OzcanBYK/OdaLambasi/Oda Lambası Mekanik Tasarım/3D Baskı/Oda Lambası - Plastik Kapak w DC Barrel.step

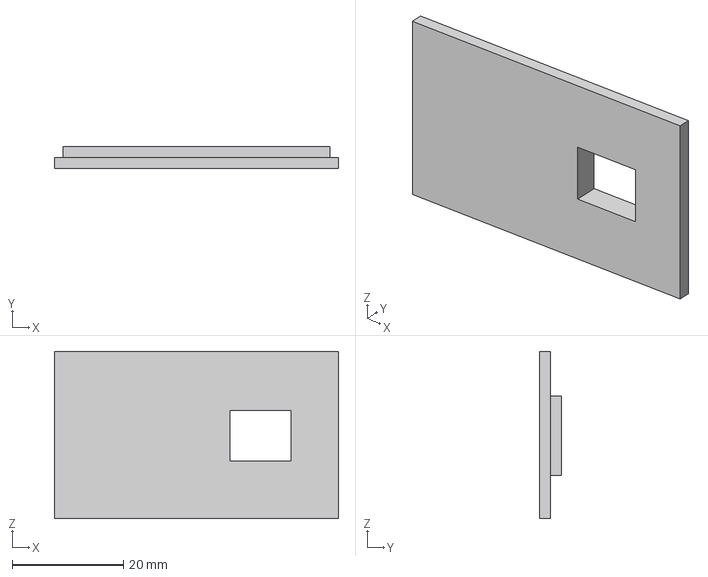
[picture p1: CAD file, 2023-02-04]
Oda Lambası Mekanik Tasarım/3D Baskı/Oda Lambası - Plastik Kapak w DC Barrel.step
51.0 x 4.00 x 30.0 mm
