OzcanBYK/OdaLambasi/Oda Lambası Mekanik Tasarım/Elektronik Parçalar/3.5 2'li Dişi Yatay Geçmeli Klemens.step

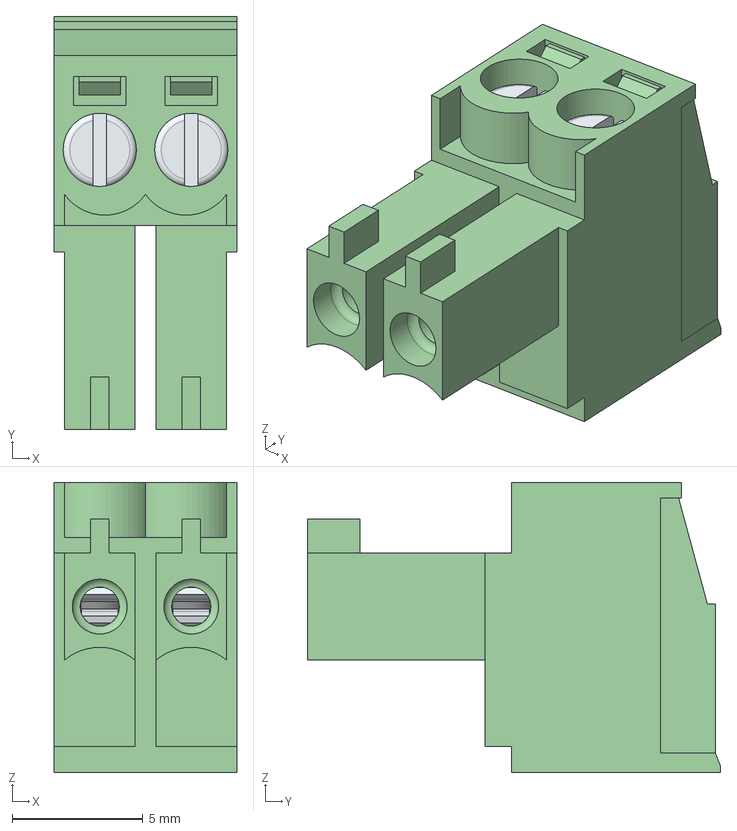
[picture p2: CAD file, 2023-02-04]
Oda Lambası Mekanik Tasarım/Elektronik Parçalar/3.5 2'li Dişi Yatay Geçmeli Klemens.step
7.00 x 15.8 x 11.1 mm
691364100002_M
6913611000xx_CAGE x 2
6913611000xx_VIS x 2
6913611000xx_PIN x 2
