OzcanBYK/OdaLambasi/Oda Lambası Mekanik Tasarım/Mekanik Parçalar/Oda Lambası - Pleksi.step

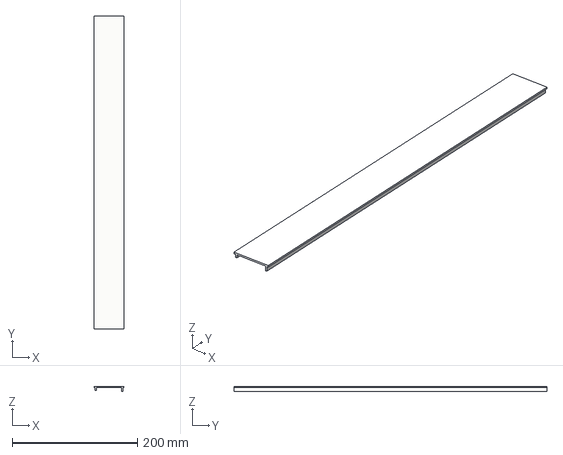
[picture p3: CAD file, 2023-02-04]
Oda Lambası Mekanik Tasarım/Mekanik Parçalar/Oda Lambası - Pleksi.step
48.0 x 500.0 x 8.00 mm
