OzcanBYK/OdaLambasi/Oda Lambası Mekanik Tasarım/3D Baskı/Oda Lambası - Kart Sabitleme Üst.step

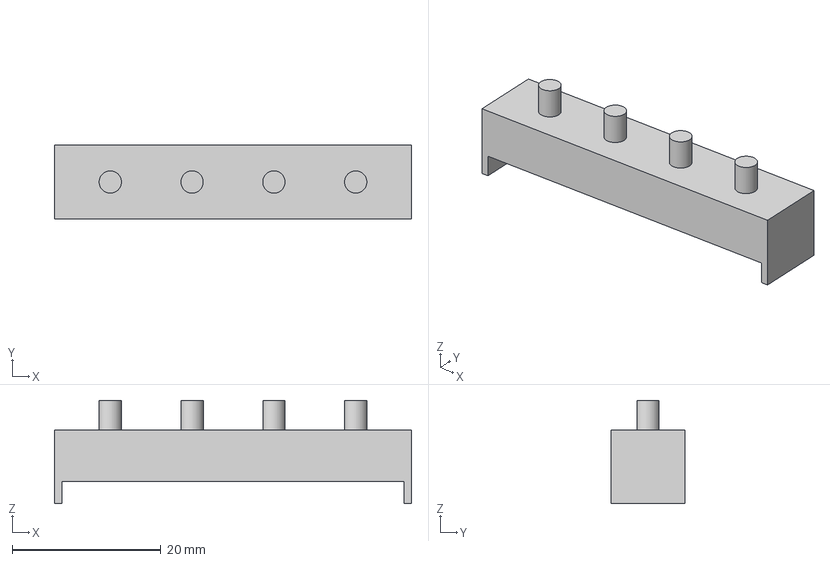
[picture p4: CAD file, 2023-02-04]
Oda Lambası Mekanik Tasarım/3D Baskı/Oda Lambası - Kart Sabitleme Üst.step
48.0 x 10.0 x 13.9 mm
