OzcanBYK/OdaLambasi/Oda Lambası Mekanik Tasarım/Elektronik Parçalar/DC Barrel Jack.step

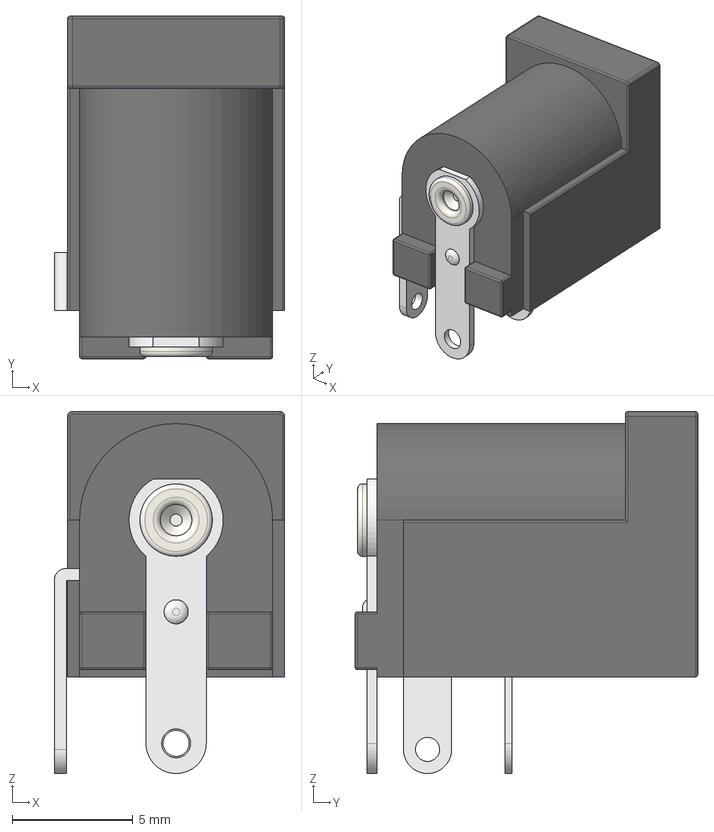
[picture p5: CAD file, 2023-02-04]
Oda Lambası Mekanik Tasarım/Elektronik Parçalar/DC Barrel Jack.step
9.55 x 14.2 x 15.0 mm
