OzcanBYK/OdaLambasi/Oda Lambası Mekanik Tasarım/Mekanik Parçalar/Oda Lambası - Aliminyum Gövde.step

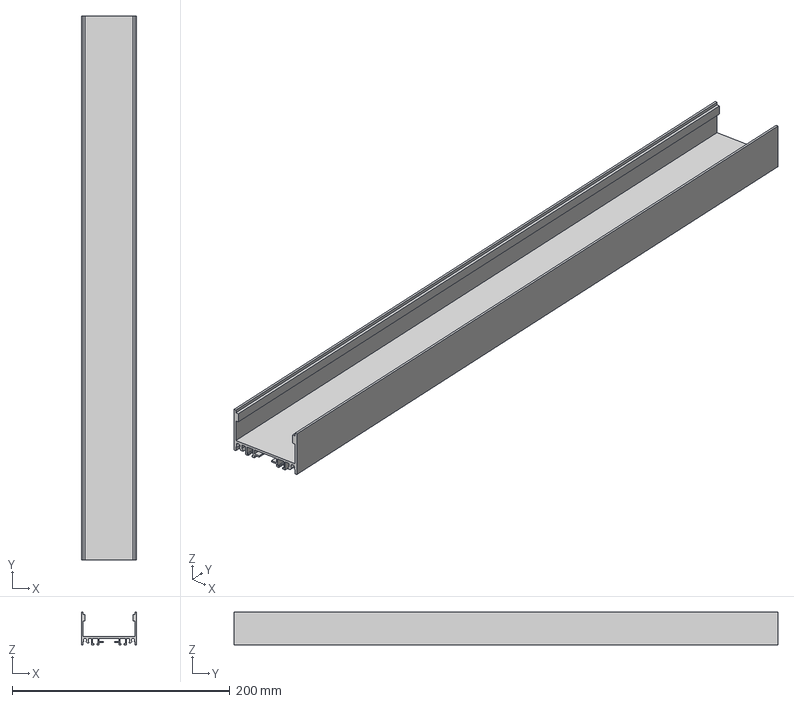
[picture p6: CAD file, 2023-02-04]
Oda Lambası Mekanik Tasarım/Mekanik Parçalar/Oda Lambası - Aliminyum Gövde.step
51.0 x 500.0 x 30.0 mm
