OzcanBYK/OdaLambasi/Oda Lambası Mekanik Tasarım/Elektronik Parçalar/3.5 4'lü Dişi Yatay Geçmeli Klemens.step

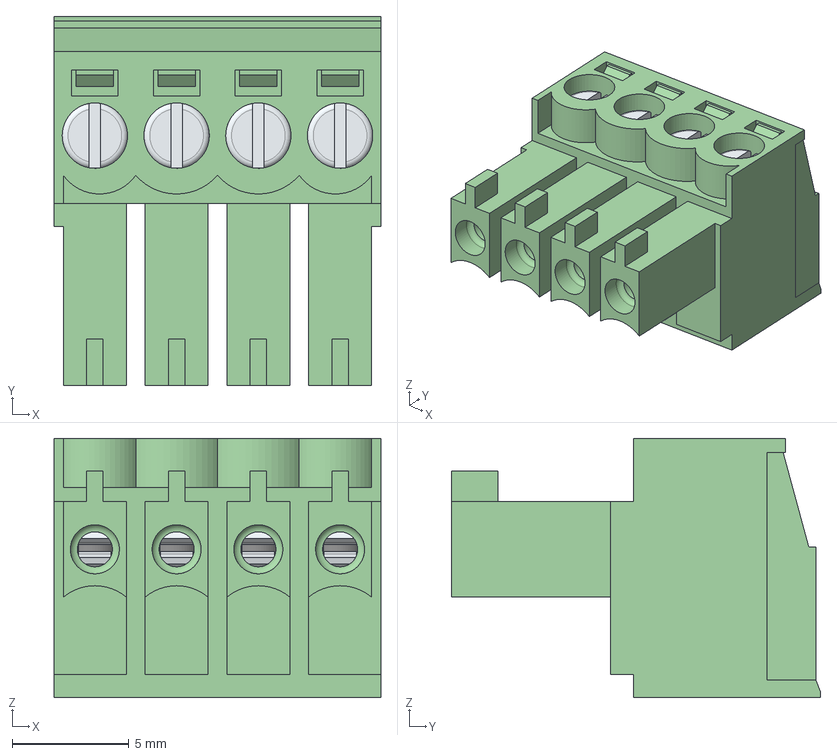
[picture p7: CAD file, 2023-02-04]
Oda Lambası Mekanik Tasarım/Elektronik Parçalar/3.5 4'lü Dişi Yatay Geçmeli Klemens.step
14.0 x 15.8 x 11.1 mm
6913611000xx_CAGE x 4
6913611000xx_VIS x 4
6913611000xx_PIN x 4
691364100004_M
