OzcanBYK/OdaLambasi/Oda Lambası Mekanik Tasarım/3D Baskı/Oda Lambası - Kart Sabitleme Alt.step

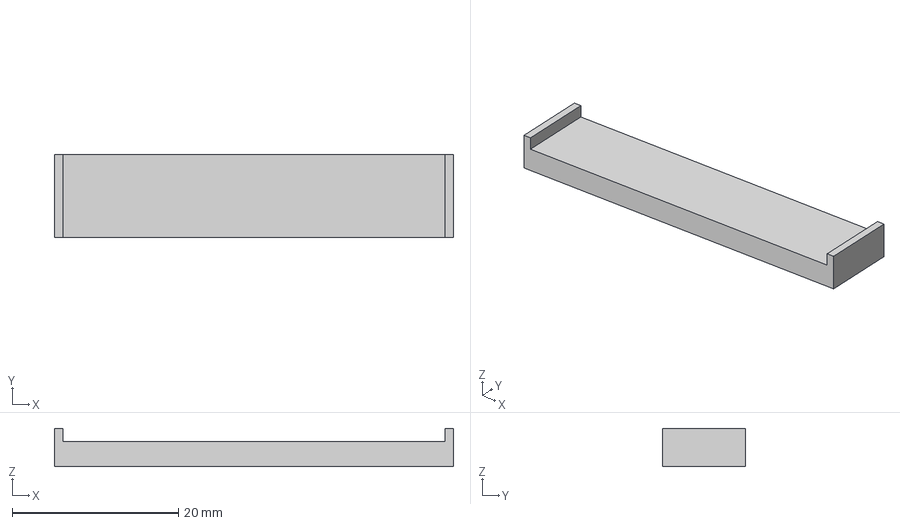
[picture p8: CAD file, 2023-02-04]
Oda Lambası Mekanik Tasarım/3D Baskı/Oda Lambası - Kart Sabitleme Alt.step
48.0 x 10.0 x 4.60 mm
