OzcanBYK/OdaLambasi/Oda Lambası Mekanik Tasarım/Elektronik Parçalar/Oda Lambası Led.step

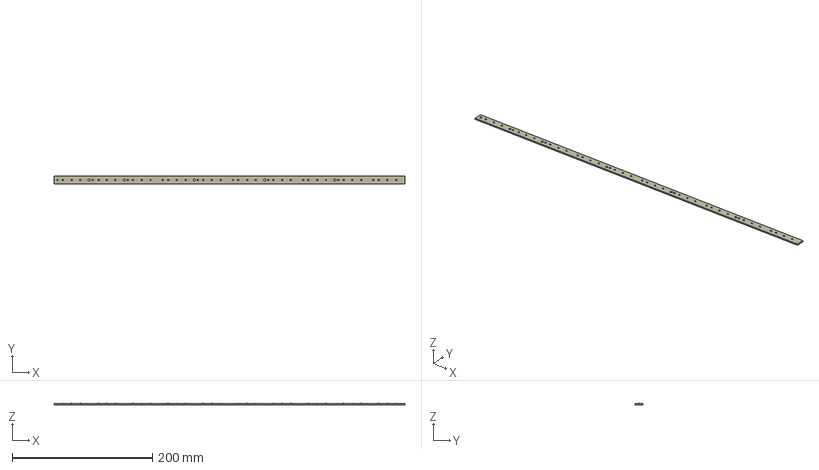
[picture p9: CAD file, 2023-02-04]
Oda Lambası Mekanik Tasarım/Elektronik Parçalar/Oda Lambası Led.step
500.0 x 11.0 x 2.42 mm
Board
R0805 x 10
