OzcanBYK/OdaLambasi/Oda Lambası Mekanik Tasarım/3D Baskı/Oda Lambası - Led Sabitleme.step

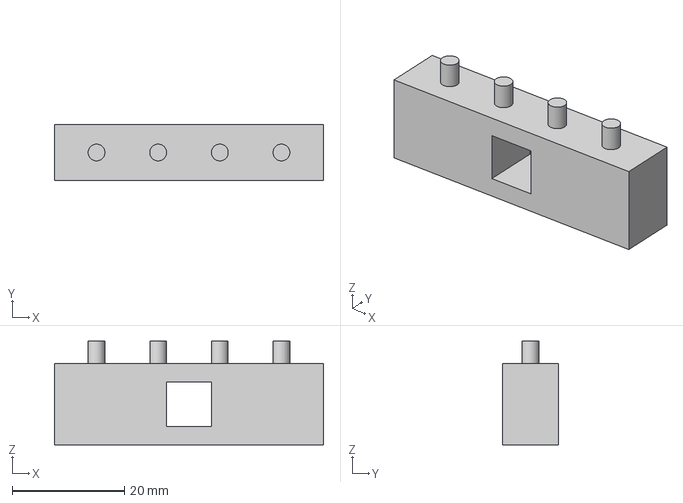
[picture p10: CAD file, 2023-02-04]
Oda Lambası Mekanik Tasarım/3D Baskı/Oda Lambası - Led Sabitleme.step
48.0 x 10.0 x 18.5 mm
