OzcanBYK/OdaLambasi/(list of files, cad)

Other CAD files:
Oda Lambası Mekanik Tasarım/3D Baskı/Oda Lambası - Plastik Kapak.step
