OzcanBYK/OdaLambasi/Kart Tasarımları/Oda Lambası V0.01.brd

## EAGLE design Kart Tasarımları/Oda Lambası V0.01.brd (2023-01-30)

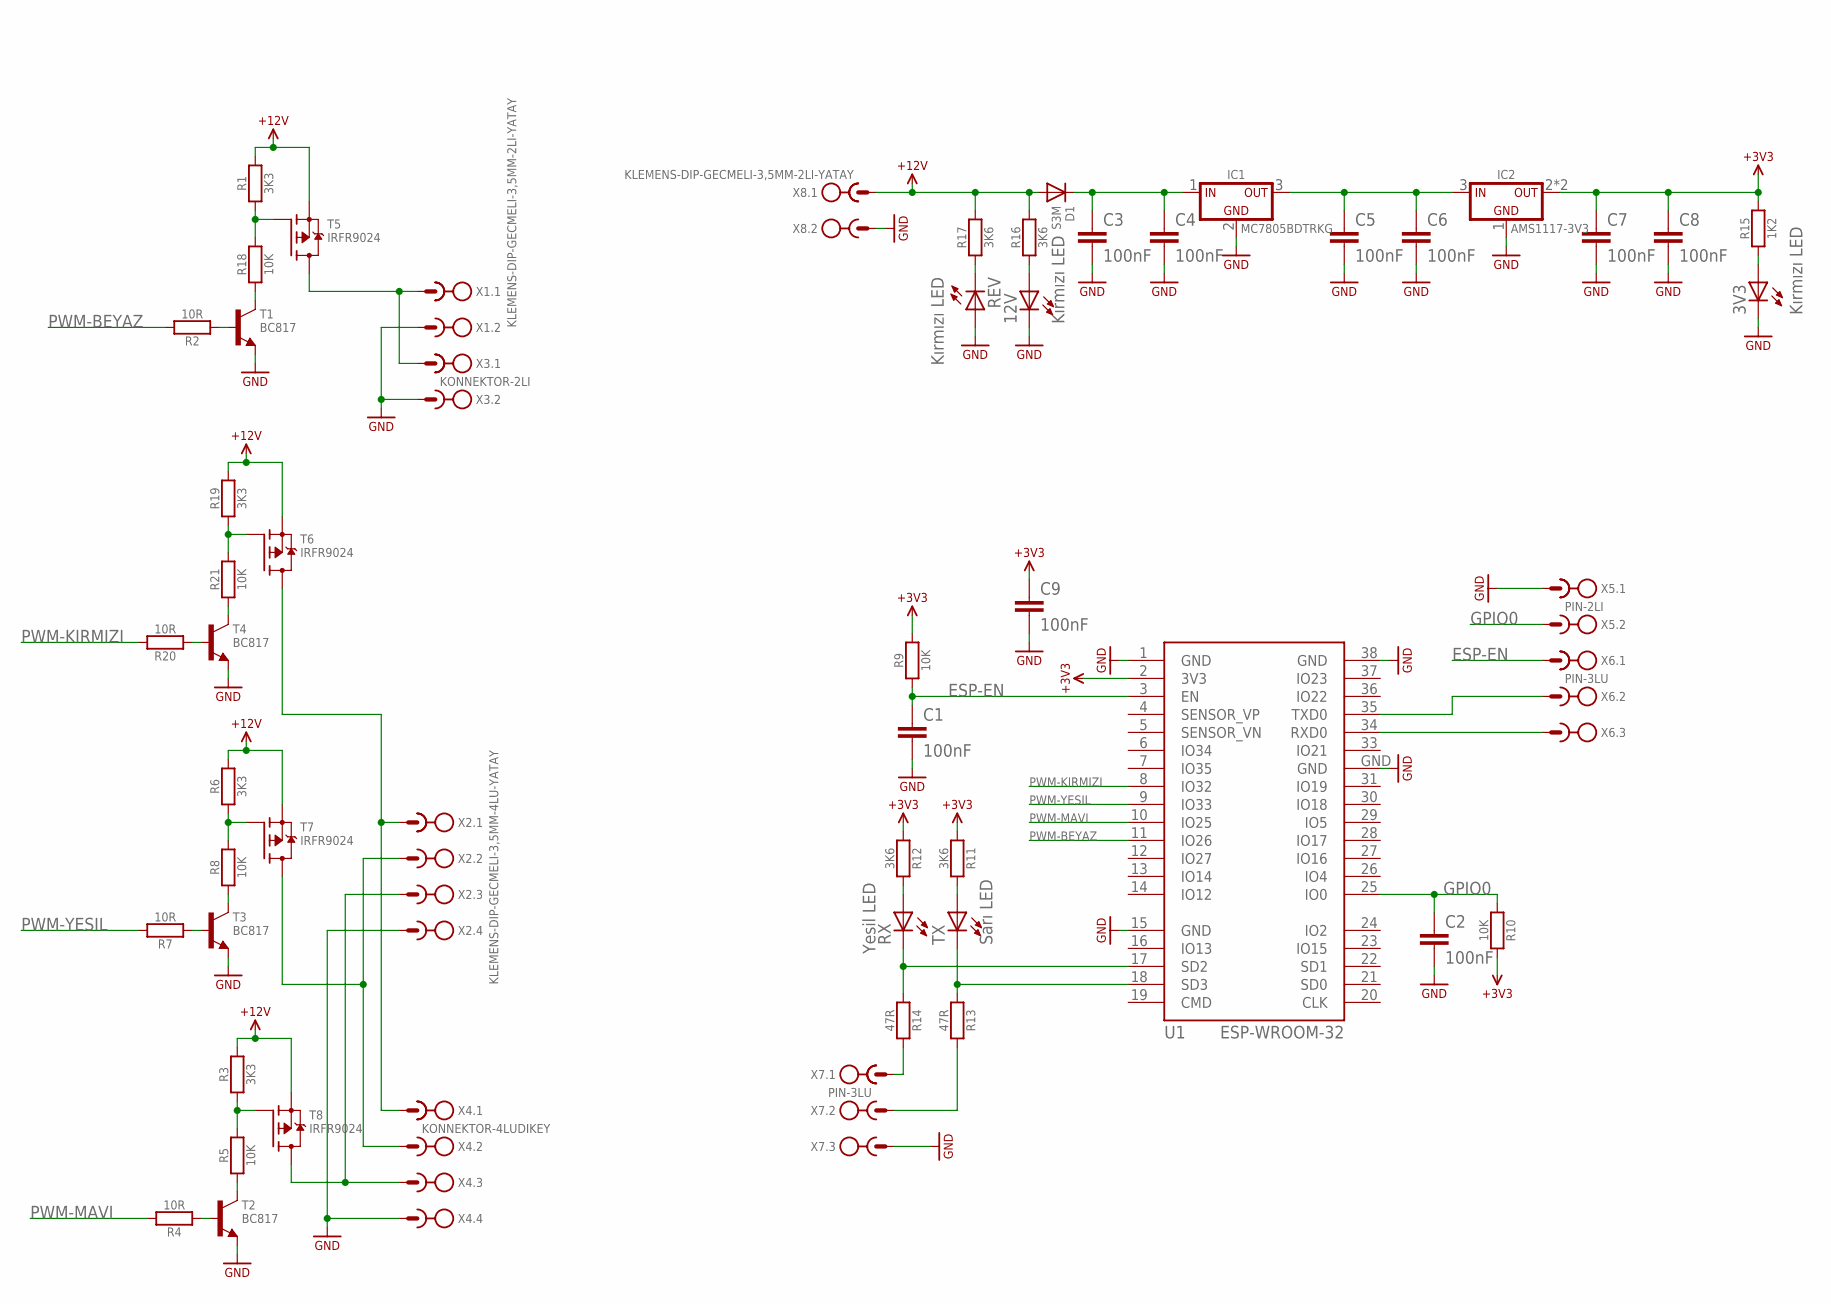
[picture p11: schematic Oda Lambası V0.01.sch]

Parts:
3V3, 12V: Kırmızı LED; 0805
C1, C2, C3, C4, C5, C6, C7, C8, C9: 100nF; C1206
D1: S3M; SMC
IC1: MC7805BDTRKG; DPAK
IC2: AMS1117-3V3; SOT223
R1, R3, R6, R19: 3K3; R1206
R2, R4, R7, R20: 10R; R1206
R5, R8, R9, R10, R18, R21: 10K; R1206
R11, R12, R16, R17: 3K6; R1206
R13, R14: 47R; R1206
R15: 1K2; R1206
REV: Kırmızı LED; 0805
RX: Yesil LED; 0805
T1, T2, T3, T4: BC817; SOT23
T5, T6, T7, T8: IRFR9024; DPAK
TX: Sarı LED; 0805
U1: ESP-WROOM-32
X1, X8: KLEMENS-DIP-GECMELI-3,5MM-2LI-YATAY
X2: KLEMENS-DIP-GECMELI-3,5MM-4LU-YATAY
X3: KONNEKTOR-2LI; MOLEX-DIP-2LI-YATAY
X4: KONNEKTOR-4LUDIKEY; MOLEX-DIP-4LU-DIKEY
X5: PIN-2LI; PINHEADER-DIP-2-2.54
X6, X7: PIN-3LU; PINHEADER-DIP-3-2.54

Connections:
+3V3: C7.1, C8.1, C9.1, IC2.2 (OUT), IC2.4 (OUT), R9.2, R10.2, R11.2, R12.2, R15.2, U1.2 (3V3)
+12V: D1.A, R1.2, R3.2, R6.2, R16.2, R17.2, R19.2, T5.3 (S), T6.3 (S), T7.3 (S), T8.3 (S), X8.1
ESP-EN: C1.1, R9.1, U1.3 (EN), X6.1
GND: 3V3.C, 12V.C, C1.2, C2.2, C3.2, C4.2, C5.2, C6.2, C7.2, C8.2, C9.2, IC1.2 (GND), IC2.1 (GND), REV.A, T1.2 (E), T2.2 (E), T3.2 (E), T4.2 (E), U1.1 (GND), U1.15 (GND), U1.38 (GND), U1.GND, X1.2, X2.4, X3.2, X4.4, X5.1, X7.3, X8.2
GPIO0: C2.1, R10.1, U1.25 (IO0), X5.2
unnamed: R1.1, R18.2, T5.1 (G)
unnamed: R3.1, R5.2, T8.1 (G)
unnamed: R5.1, T2.3 (C)
unnamed: R4.1, T2.1 (B)
unnamed: T6.2 (D), X2.1, X4.1
unnamed: T8.2 (D), X2.3, X4.3
unnamed: T5.2 (D), X1.1, X3.1
unnamed: U1.35 (TXD0), X6.2
unnamed: U1.34 (RXD0), X6.3
unnamed: R18.1, T1.3 (C)
unnamed: R2.1, T1.1 (B)
unnamed: R6.1, R8.2, T7.1 (G)
unnamed: R8.1, T3.3 (C)
unnamed: R11.1, TX.A
unnamed: R12.1, RX.A
unnamed: C3.1, C4.1, D1.C, IC1.1 (IN)
unnamed: C5.1, C6.1, IC1.3 (OUT), IC2.3 (IN)
unnamed: R14.1, X7.1
unnamed: R13.1, X7.2
unnamed: R13.2, TX.C, U1.18 (SD3)
unnamed: R14.2, RX.C, U1.17 (SD2)
unnamed: 3V3.A, R15.1
unnamed: 12V.A, R16.1
unnamed: R17.1, REV.C
unnamed: R7.1, T3.1 (B)
unnamed: R19.1, R21.2, T6.1 (G)
unnamed: R21.1, T4.3 (C)
unnamed: R20.1, T4.1 (B)
unnamed: T7.2 (D), X2.2, X4.2
PWM-BEYAZ: R2.2, U1.11 (IO26)
PWM-KIRMIZI: R20.2, U1.8 (IO32)
PWM-MAVI: R4.2, U1.10 (IO25)
PWM-YESIL: R7.2, U1.9 (IO33)

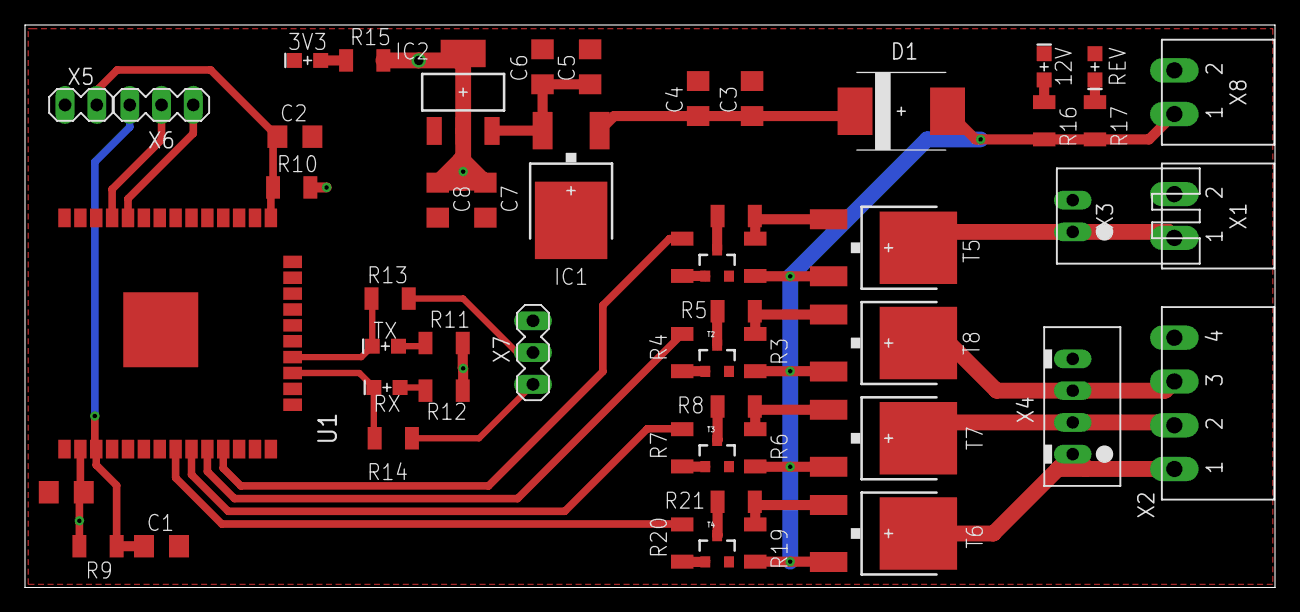
[picture p12: board Oda Lambası V0.01.brd from above]

Board: 2 copper layers, 100.0 x 45.0 mm, 55 parts (0 on the bottom side), 38 nets.
