OzcanBYK/OdaLambasi/(commit log)

2023-01-30 Mosfet Testi
    Mosfet Test Etmek için oda lambası projesinin led sürme kısmı yazıldı.
2023-01-30 Kart Tasarımı Eklendi
    Kart tasarımı ve gerber dosyaları eklendi
    [Oda Lambası V0.01.brd, Oda Lambası V0.01.sch]
2023-02-04 Mekanik Tasarım
    Lambanın 3 boyutlu tasarımı eklenmiştir
    [3.5 2'li Dişi Yatay Geçmeli Klemens.step, 3.5 4'lü Dişi Yatay Geçmeli Klemens.step, DC Barrel Jack.step, Oda Lambası - Aliminyum Gövde.step, Oda Lambası - Kart Sabitleme Alt.step, Oda Lambası - Kart Sabitleme Üst.step, Oda Lambası - Led Sabitleme.step, Oda Lambası - Plastik Kapak w DC Barrel.step]
