OzcanBYK/OdaLambasi/(notices)

Notices in the files:
parts and their libraries:
Ozcan-ESP32: Creative Commons Attribution-ShareAlike 4.0 International
